acmoneyclip/nameless-nineski/LED sniffer project/LED sniffer project.jpg

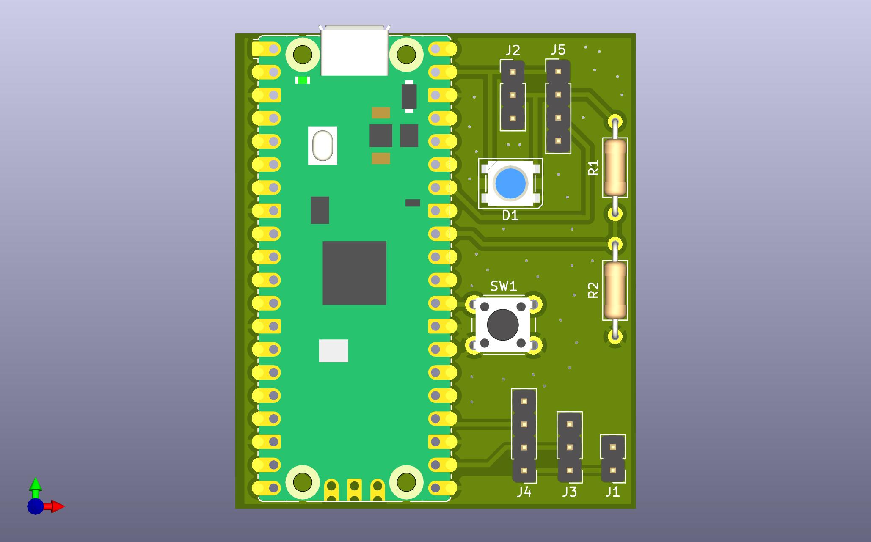
LED sniffer project/LED sniffer project.jpg
