acmoneyclip/nameless-nineski/LED sniffer project/LED Sniffer Project.pdf

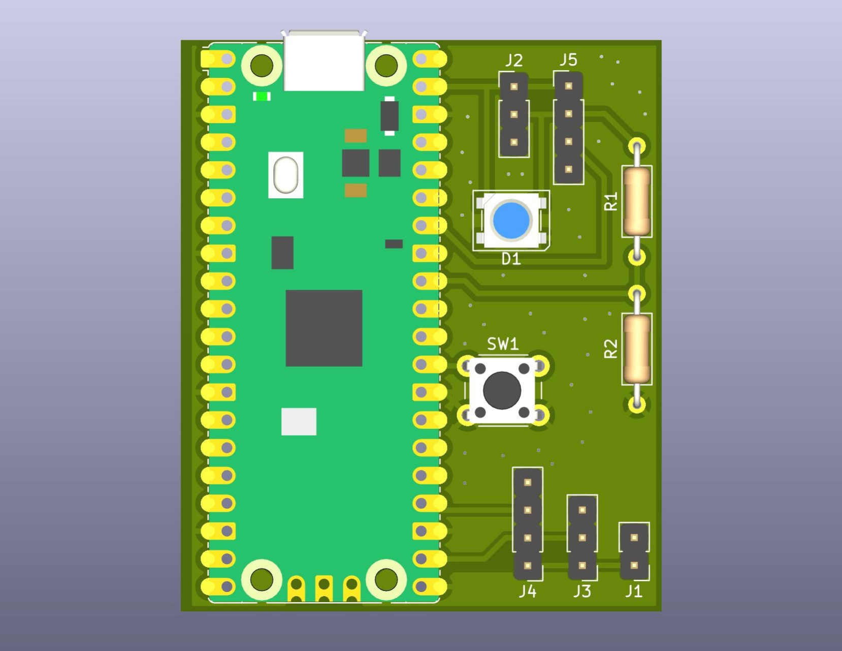
[picture p2: page 1]
