acmoneyclip/nameless-nineski/Team 09_Assignment 07_BOM.xlsx

Bill Of Materials for: Team 09_Aaron_Jacob_Fangdong_Mim
Last modified: 11/12/2025
PCB version: [PCB Rev 1.0r0]
BOM revision: [BOM Rev 1.0r0]
Qty | Reference Designators | Mfr | Mfr Part Number | Description | Dist | Dist Part Number | Cost Ea. | Cost Total
2 | C1, C2 | KEMET (https://www.digikey.com/en/supplier-centers/kemet) | C1206C104K5RACTU | CAP CER 0.1UF 50V X7R 1206 | Digi-Key | 399-C1206C104K5RACTUTR-ND | $0.08 | $0.16
1 | C3 | Samsung Electro-Mechanics (https://www.digikey.com/en/supplier-centers/samsung-electro-mechanics-america) | CL31A476MQHNNNE | CAP CER 47UF 6.3V X5R 1206 | Digi-Key | 1276-1167-2-ND | $0.31 | $0.31
1 | D1 | Everlight Electronics Co Ltd (https://www.digikey.com/en/supplier-centers/everlight-electronics) | SIR67-21C/TR8 | EMITTER IR 875NM 65MA SMD | Digi-Key | 1080-1427-2-ND | $0.31 | $0.31
1 | J1 | Sullins Connector Solutions (https://www.digikey.com/en/supplier-centers/sullins-connector-solutions) | PRPC002SAAN-RC | CONN HEADER VERT 2POS 2.54MM | Digi-Key | S1011EC-02-ND | $0.30 | $0.30
1 | LS1 | Soberton Inc. (https://www.digikey.com/en/supplier-centers/soberton) | SP-4005Y | SPEAKER 8OHM 1W TOP PORT 88DB | Digi-Key | 433-1270-ND | $2.09 | $2.09
1 | PICO_GEN1 | Raspberry Pi (https://www.digikey.com/en/supplier-centers/raspberry-pi) | SC0915 | RASPBERRY PI PICO RP2040 | Digi-Key | 2648-SC0915TR-ND | $4.00 | $4.00
1 | Q1 | Lumimax Optoelectronic Technology (https://www.digikey.com/en/supplier-centers/lumimax-optoelectronic-technology) | 2N3904 | TRANS NPN 40V 0.2A TO-92 | Digi-Key | 4491-2N3904-ND | $0.15 | $0.15
1 | R1 | YAGEO (https://www.digikey.com/en/supplier-centers/yageo) | RC1206FR-071KL | RES 1K OHM 1% 1/4W 1206 | Digi-Key | 311-1.00KFRTR-ND | $0.10 | $0.10
1 | R2 | Vishay Dale (https://www.digikey.com/en/supplier-centers/vishay) | TNPW1206100KBEEA | RES 100K OHM 0.1% 0.52W 1206 | Digi-Key | TNP100KACTR-ND | $0.41 | $0.41
1 | R3 | KOA Speer Electronics, Inc. (https://www.digikey.com/en/supplier-centers/koa-speer) | RK73H2BTTD3300F | RES 330 OHM 1% 1/4W 1206 | Digi-Key | 2019-RK73H2BTTD3300FTR-ND | $0.10 | $0.10
1 | SW | Omron Electronics Inc-EMC Div (https://www.digikey.com/en/supplier-centers/omron) | B3F-1000 | SWITCH TACTILE SPST-NO 0.05A 24V | Digi-Key | SW400-ND | $0.24 | $0.24
1 | PCB | Vector Electronics (https://www.digikey.com/en/supplier-centers/vector-electronics-and-technology) | 12X12WE | PROTO BOARD UNCLAD 12" X 12" | Digikey | V2041-ND | $22.32 | $22.32
 |  |  |  |  |  |  | TOTAL: | $30.49
VERSION INFO
Rev | Date
1.0r0 | 2025-11-12
