acmoneyclip/nameless-nineski/LED sniffer project/Schematic.pdf

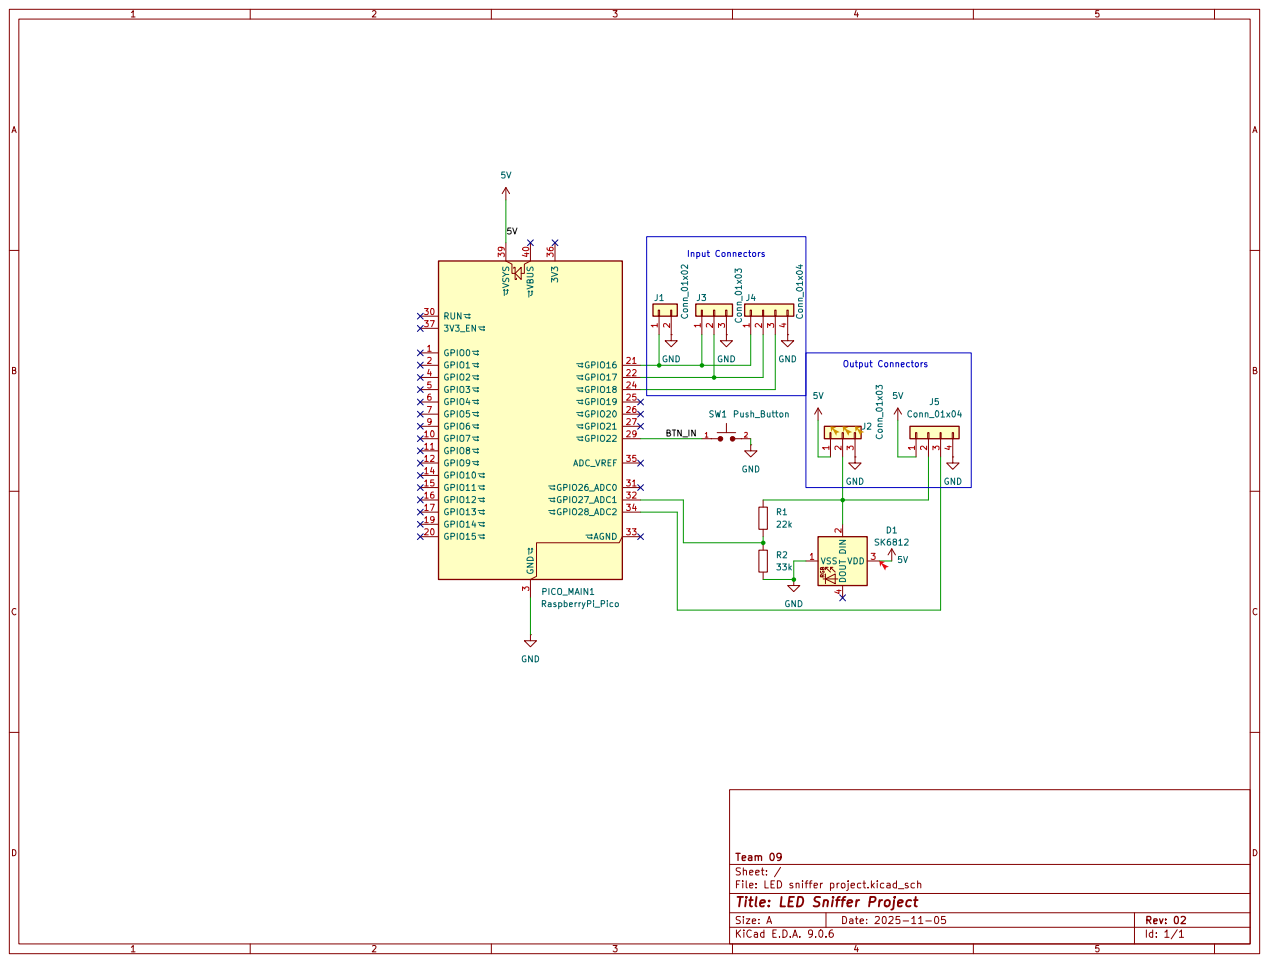
[picture p3: page 1]
