acmoneyclip/nameless-nineski/LED sniffer project/Final Cad.pdf

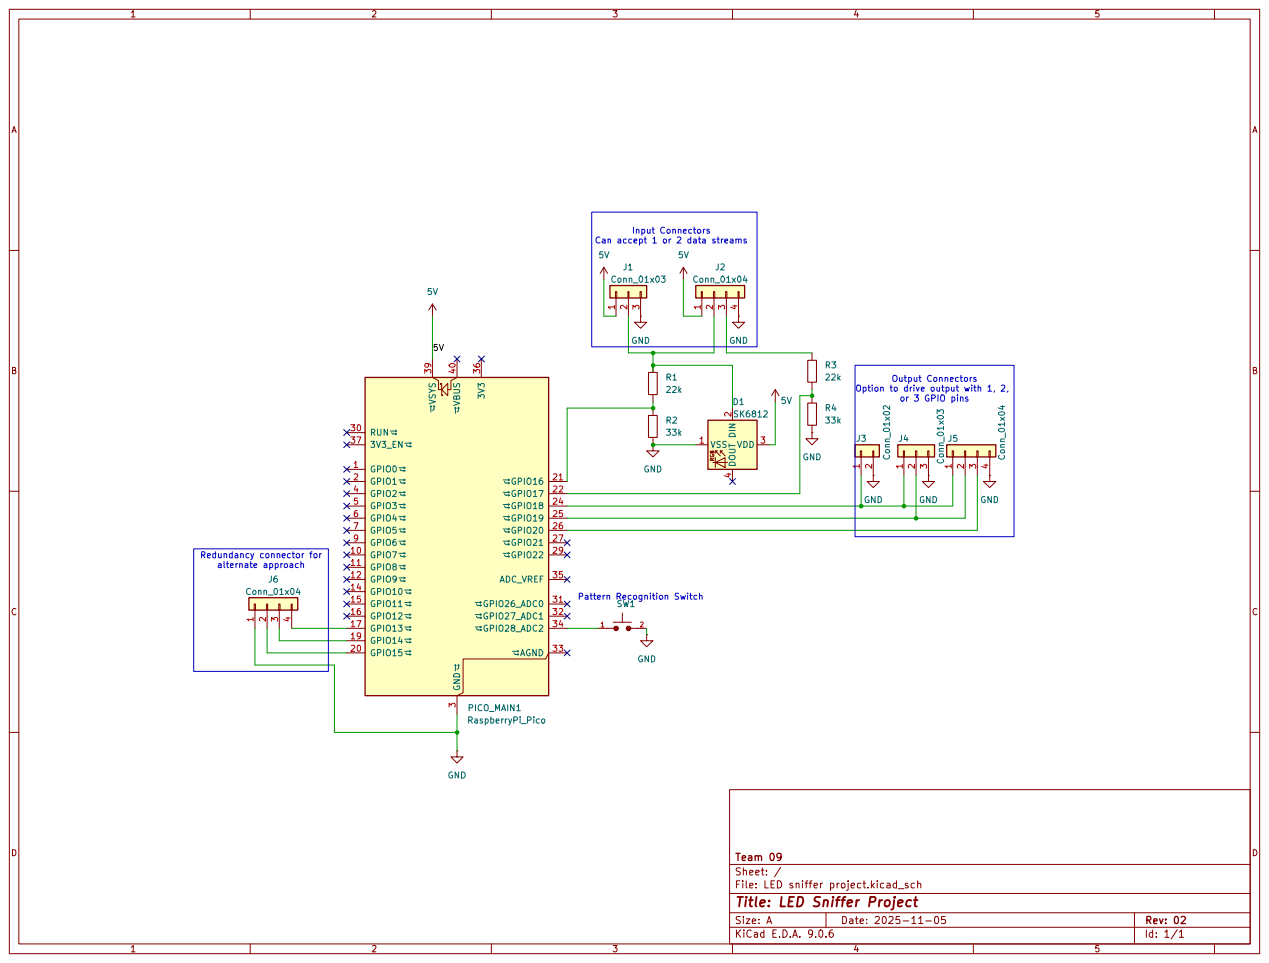
[picture p9: page 1]
