acmoneyclip/nameless-nineski/LED sniffer project/Board.pdf

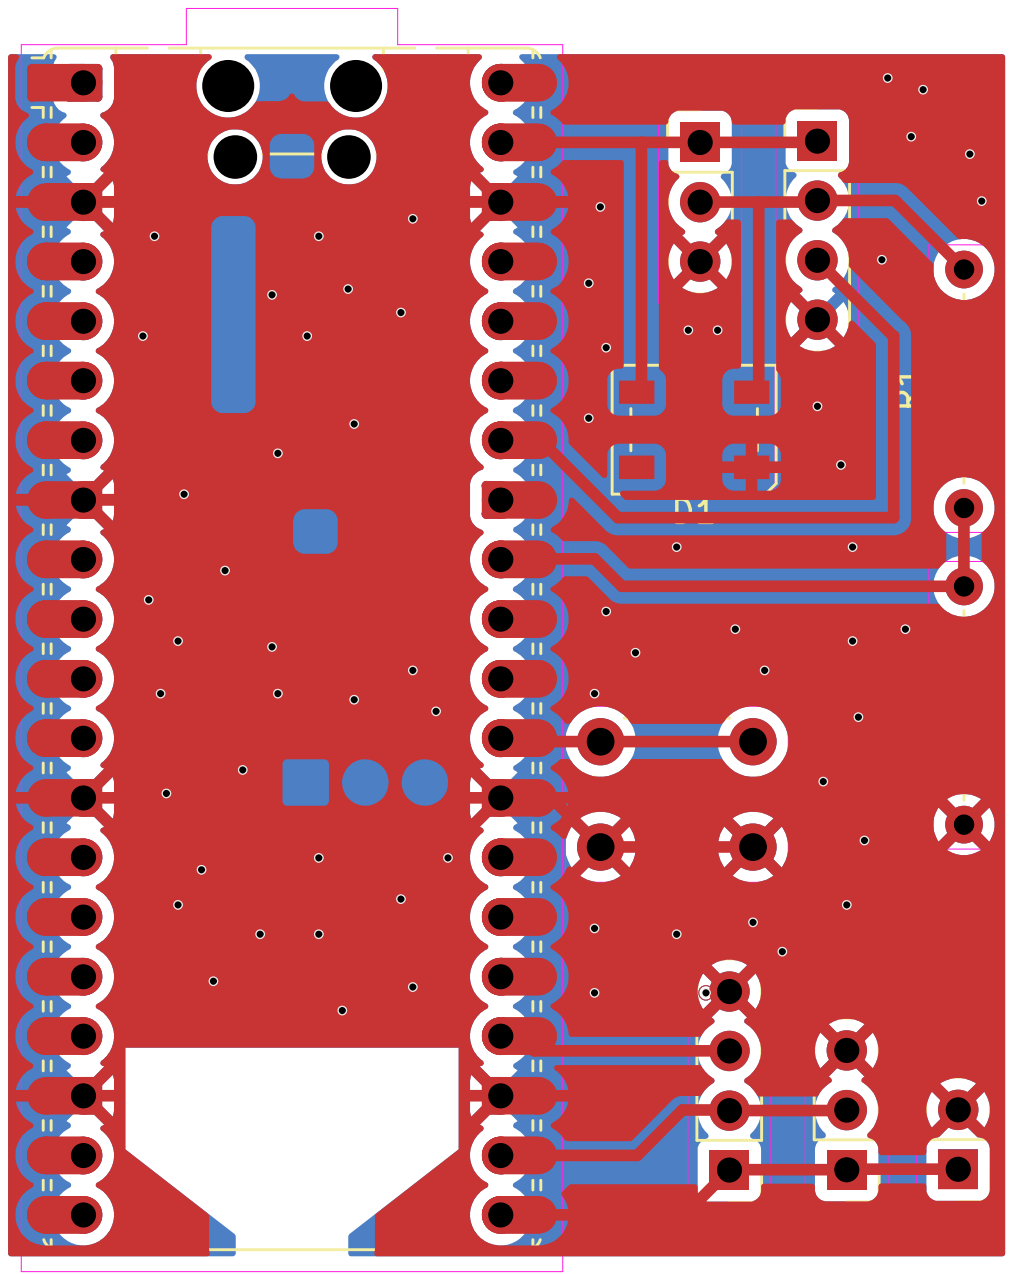
[picture p10: page 1]
