acmoneyclip/nameless-nineski/LED sniffer project/LED sniffer project.kicad_pcb

## KiCad design LED sniffer project/LED sniffer project.kicad_pcb (2025-11-20)

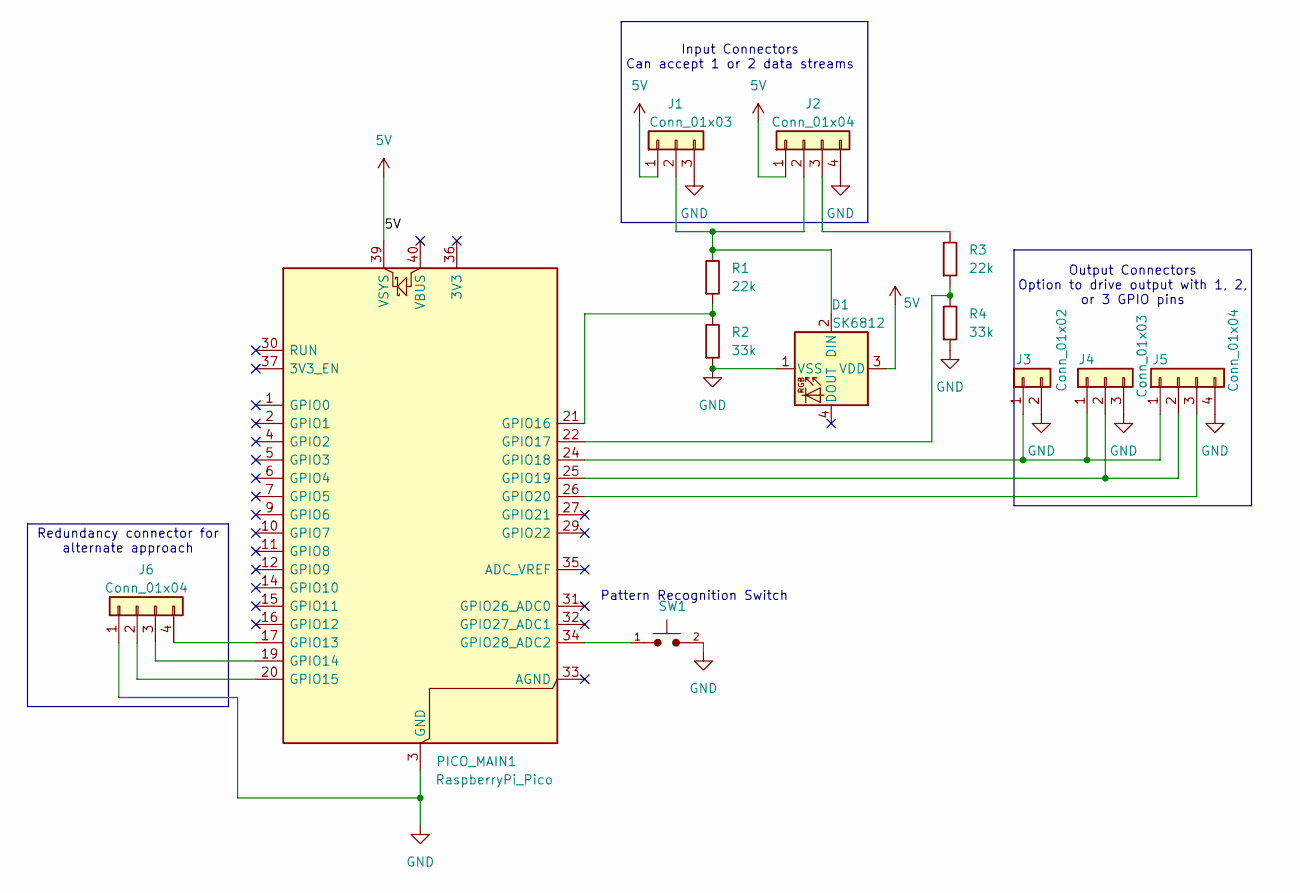
[picture p11: schematic LED sniffer project.kicad_sch]

Parts:
D1: SK6812; LED_SK6812_PLCC4_5.0x5.0mm_P3.2mm
J1, J4: Conn_01x03; PinHeader_1x03_P2.54mm_Vertical; Part Number 1-0301FBV0T
J2, J5, J6: Conn_01x04; PinHeader_1x04_P2.54mm_Vertical; Part Number 1-0401FBV0T
J3: Conn_01x02; PinHeader_1x02_P2.54mm_Vertical; Part Number 1-0201FBV0T
PICO_MAIN1: RaspberryPi_Pico; RaspberryPi_Pico_Common_Unspecified
R1, R3: 22k; R_0603_1608Metric
R2, R4: 33k; R_0603_1608Metric
SW1: Push_Button; SW_PUSH_6mm

Connections:
5V: D1.3 (VDD), J1.1, J2.1, PICO_MAIN1.39 (VSYS)
GND: D1.1 (VSS), J1.3, J2.4, J3.2, J4.3, J5.4, J6.1, PICO_MAIN1.3 (GND), PICO_MAIN1.8 (GND), PICO_MAIN1.13 (GND), PICO_MAIN1.18 (GND), PICO_MAIN1.23 (GND), PICO_MAIN1.28 (GND), PICO_MAIN1.38 (GND), R2.1, R4.1, SW1.2
unnamed: D1.2 (DIN), J1.2, J2.2, R1.2
unnamed: J2.3, R3.2
unnamed: J3.1, J4.1, J5.1, PICO_MAIN1.24 (GPIO18)
unnamed: J4.2, J5.2, PICO_MAIN1.25 (GPIO19)
unnamed: J5.3, PICO_MAIN1.26 (GPIO20)
unnamed: J6.2, PICO_MAIN1.20 (GPIO15)
unnamed: J6.3, PICO_MAIN1.19 (GPIO14)
unnamed: J6.4, PICO_MAIN1.17 (GPIO13)
unnamed: PICO_MAIN1.21 (GPIO16), R1.1, R2.2
unnamed: PICO_MAIN1.22 (GPIO17), R3.1, R4.2
unnamed: PICO_MAIN1.34 (GPIO28_ADC2), SW1.1

Notes on the sheet:
Output Connectors Option to drive output with 1, 2, or 3 GPIO pins
Pattern Recognition Switch
Input Connectors Can accept 1 or 2 data streams
Redundancy connector for alternate approach

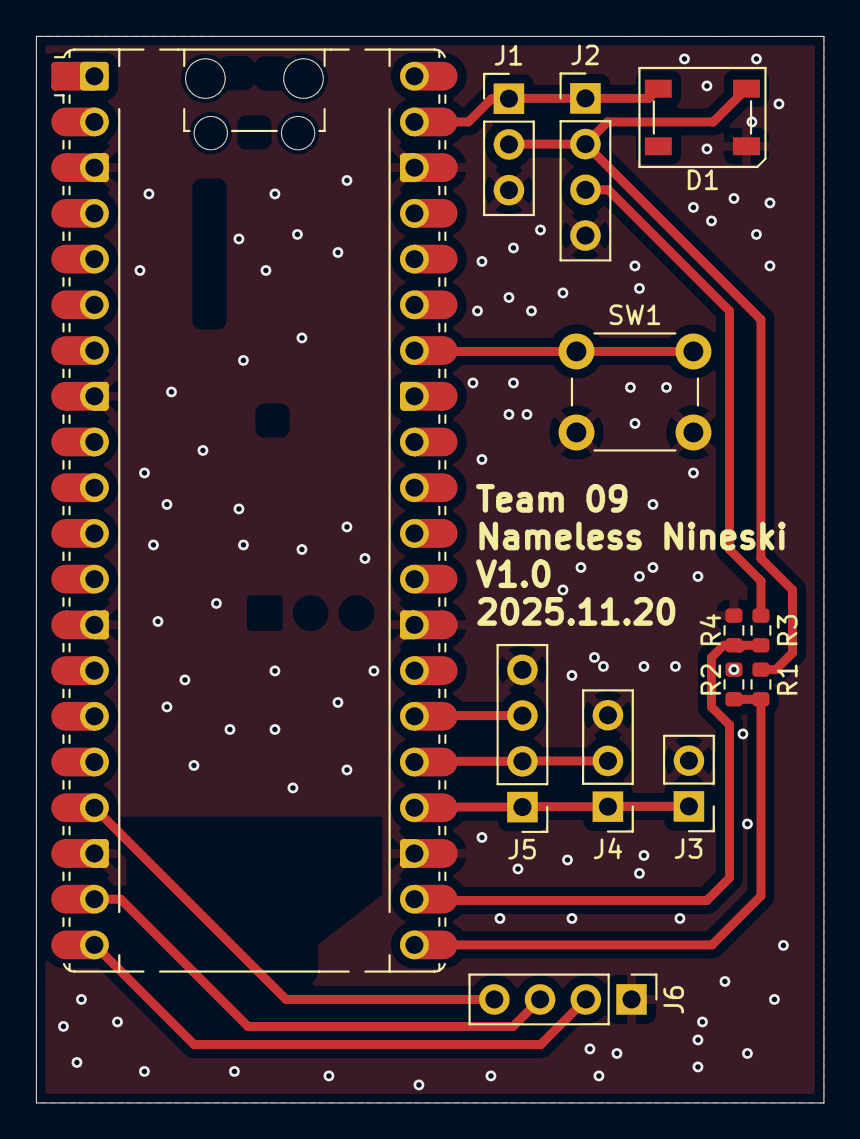
[picture p12: board LED sniffer project.kicad_pcb from above]

Board: 2 copper layers, 43.8 x 59.2 mm, 13 parts (0 on the bottom side), 13 nets.
