acmoneyclip/nameless-nineski/Example Test Case - LED Sniffer.pdf

Example Test Case

Test Author: Aaron Carlson
Test Case Name: | Sniffer Learn & Trigger on Color (Not a real test. For demonstration purposes only) | Test ID #: | Hypothetical
| Verify that the sniffer boots to idle, enters and exits learn mode with the switch, learns one input color, and only beeps when that learned color is present (and not for a different color). | Type: | □ white box □x black box □ ________

Tester Information
Name of Tester: | Your mom | Date: | 12/03/2025
HW/SW Version: | Sniffer PCB Rev A, Firmware v0.1 | Time: | 10:36pm
Setup: | Sniffer board powered from 5 V (USB or bench supply).
| External NeoPixel controller (test fixture) connected to sniffer input and able to send:
| ● Learned color: solid green
| ● Different color: solid red

Speaker, on-board LED, and NeoPixel on sniffer board are visible.

Sniffer is reset before starting the test.

S T E P | Action | Expected Result | P A S S | F A I L | N / A | Comments
1 | Apply 5 V power to the sniffer | Sniffer boots; LED/NeoPixel show idle state within 5 s | x
2 | Use the external controller to send green to the input | Sniffer remains idle (no beep yet) | x
3 | Press the switch once to enter | LED/NeoPixel changes to learn indication, then returns to idle | x
2023-11-28 | Page 1 of 4

| learn mode, then release | after learning
4 | Use the controller to send red for about 10 sec | No trigger indication and no beep while red is present. | x
5 | Use the controller to send green once | Within the response time, sniffer shows trigger indication and plays one beep | x
6 | Alternate green and red a few times | Beep only on green, never on red; sniffer returns to idle after each beep | x

7
8
9
| Overall test result:

Example Matrix Test (for varying parameters)

Test Author: Aaron Carlson

Test Case Name: | Sniffer Color Trigger Reliability Matrix | Test ID #: | SNF-M01
Description: | Check that the sniffer reliably beeps for the learned color (green) and does not beep for a different color (red) over multiple trials. | Type: | □ white box □ black box □ _____________

Tester Information

| Name of Tester: | Your mom | Date: | 12/3/2025
| HW/SW Version: | 1.0 | Time: | 12:01am
| Setup: | Sniffer has already learned green as the target color using the single-switch learn procedure (as in SNF-01). External NeoPixel controller can send either green (learned color) or red (different color) to the sniffer input. One trial = show a color for long enough that the sniffer could detect it, then observe whether it beeps
T E S T | INPUTS | EXPECTED OUTPUTS | P A S S | F A I L | N / A | Comments
1 | 10 trials of green only | Sniffer beeps and shows trigger indication on all 10 green trials. | x
2 | 10 trials of red only | Sniffer never beeps and never shows trigger indication (0/10). | x

3 | 20 trials: random mix of 10 green, 10 red. | Sniffer beeps on all green trials and on no red trials (0 false). | x

4

5

6

| Overall test result:
