acmoneyclip/nameless-nineski/(commit log)

2025-10-27 Starting push for our 411 project
    [LED sniffer project.kicad_pcb, LED sniffer project.kicad_sch]
2025-11-05 Updated Schematic to Revision 2
    This was designed for building the breadboard under my understanding of the demonstration set up requirements communicated at our team meeting on 11/4/2025
    [LED sniffer project.kicad_sch]
2025-11-05 Added firmware for LED sniffer project
    This commit adds MicroPython firmware for both Raspberry Pi Pico boards used in the LED Sniffer circuit (Revision 2 schematic).
    - pico_gen_main.py: Generates a periodic digital signal on GPIO16 (Din_Gen) to simulate the LED data trigger.
    - pico_sound_main.py: Reads the trigger input, activates the speaker via 2N3904 transistor, and can later be expanded for LED response logic.
    Note: The LED_RGB in the schematic is treated as a digital (single-wire) data LED, not a 3-channel analog RGB LED.
2025-11-06 HW6 updated schematic (revision 2), initial layout, and 3D render
    [LED sniffer project.kicad_pcb, LED sniffer project.kicad_sch]
2025-11-10 Bill of Material Export from KiCad LED Sniffer Schematic (Rev 2)
    [LED sniffer project.csv]
2025-11-10 Update with current breadboard
2025-11-11 aaron's PCB file for CAD rough draft (contains 2 raspberry pi)
    I was thinking at some point that the jumper is not needed since imagine we could be connecting the raspberry pi with usb power....
    [LED sniffer project.kicad_pcb]
2025-11-12 rough draft of schematic
    [LED sniffer project.kicad_pcb, LED sniffer project.kicad_sch]
2025-11-13 Bill of Materials
    Team 09_BOM
    [Team 09_Assignment 07_BOM.xlsx]
2025-11-18 Updated with a slightly less rough draft
    [LED sniffer project.kicad_sch]
2025-11-18 Updated CAD
    [LED sniffer project.kicad_pcb, LED sniffer project.kicad_sch]
2025-11-19 Slight update
    [LED sniffer project.kicad_pcb, LED sniffer project.kicad_sch]
2025-11-19 Even more updated
    [LED sniffer project.kicad_pcb]
2025-11-20 Possible submission
    [LED sniffer project.kicad_pcb, LED sniffer project.kicad_sch]
2025-11-20 Get ready for production
    [LED sniffer project-B_Cu.gbr, LED sniffer project-B_Mask.gbr, LED sniffer project-B_Paste.gbr, LED sniffer project-B_Silkscreen.gbr, LED sniffer project-Edge_Cuts.gbr, LED sniffer project-F_Cu.gbr, LED sniffer project-F_Mask.gbr, LED sniffer project-F_Paste.gbr]
2025-11-20 Final Cad
    [LED sniffer project-B_Cu.gbr, LED sniffer project-B_Mask.gbr, LED sniffer project-B_Paste.gbr, LED sniffer project-B_Silkscreen.gbr, LED sniffer project-Edge_Cuts.gbr, LED sniffer project-F_Cu.gbr, LED sniffer project-F_Mask.gbr, LED sniffer project-F_Paste.gbr]
2025-12-03 added sniffer test plan documents
    test plan and example test case
2025-12-04 Updated Example Test Case
    Updated to explicitly identify this test case as hypothetical. An actual test can be performed when we have an MVP to test.
2025-12-04 Din Generator and Sniffer Code
    Gen: drives a NeoPixel ring on GP2, cycling R/G/B/off.
    Sniff: samples DIN on GP27, learns a target color on button press, and prints MATCH whenever the incoming NeoPixel data is close to the learned color.
2025-12-04 Update README_Din_Sniff_ac1
    added detail that code current only supports start and stopping through Thonny
2025-12-10 Test your GPIO pin to maker it's not blown
    If you're not getting a Din reading, this is a sanity check that will at least tell you if your pin is noticing more than all zeroes. Maybe it can makes sense of Din but it can still tell you it's alive. This is for GPIO27 but can easily be changed.
2025-12-12 run this before using Din_Sniff_ac1
    for some reason sniff code doesn't read any 1's unless this dummy test is run first.
    [pinTest.py]
